lendres/PCB-Name-Plate-Class-Project/Name Plate Class Project.kicad_pcb

## KiCad design Name Plate Class Project.kicad_pcb (2020-07-08)

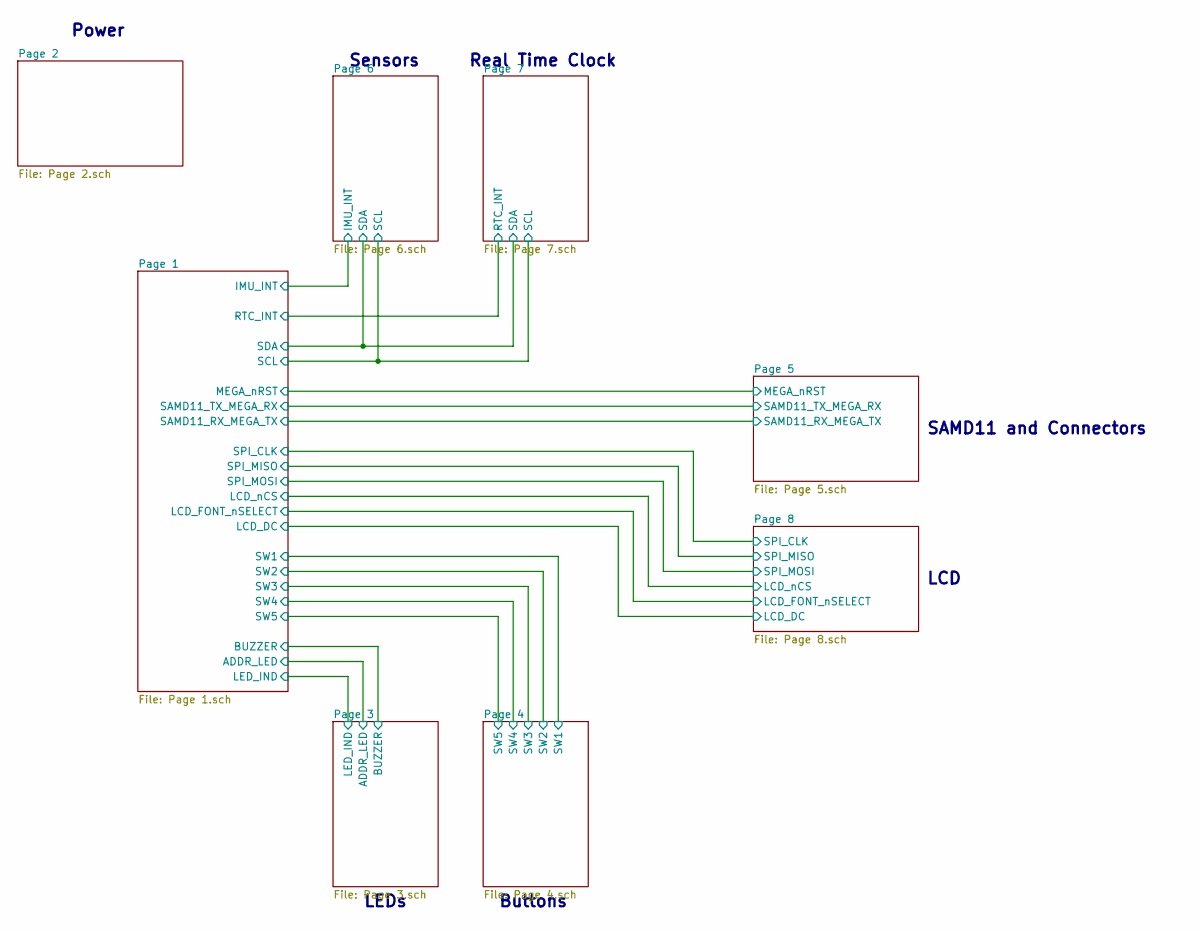
[picture p1: schematic Name Plate Class Project.sch]

Notes on the sheet:
LCD
SAMD11 and Connectors
Real Time Clock
Sensors
Power
LEDs
Buttons

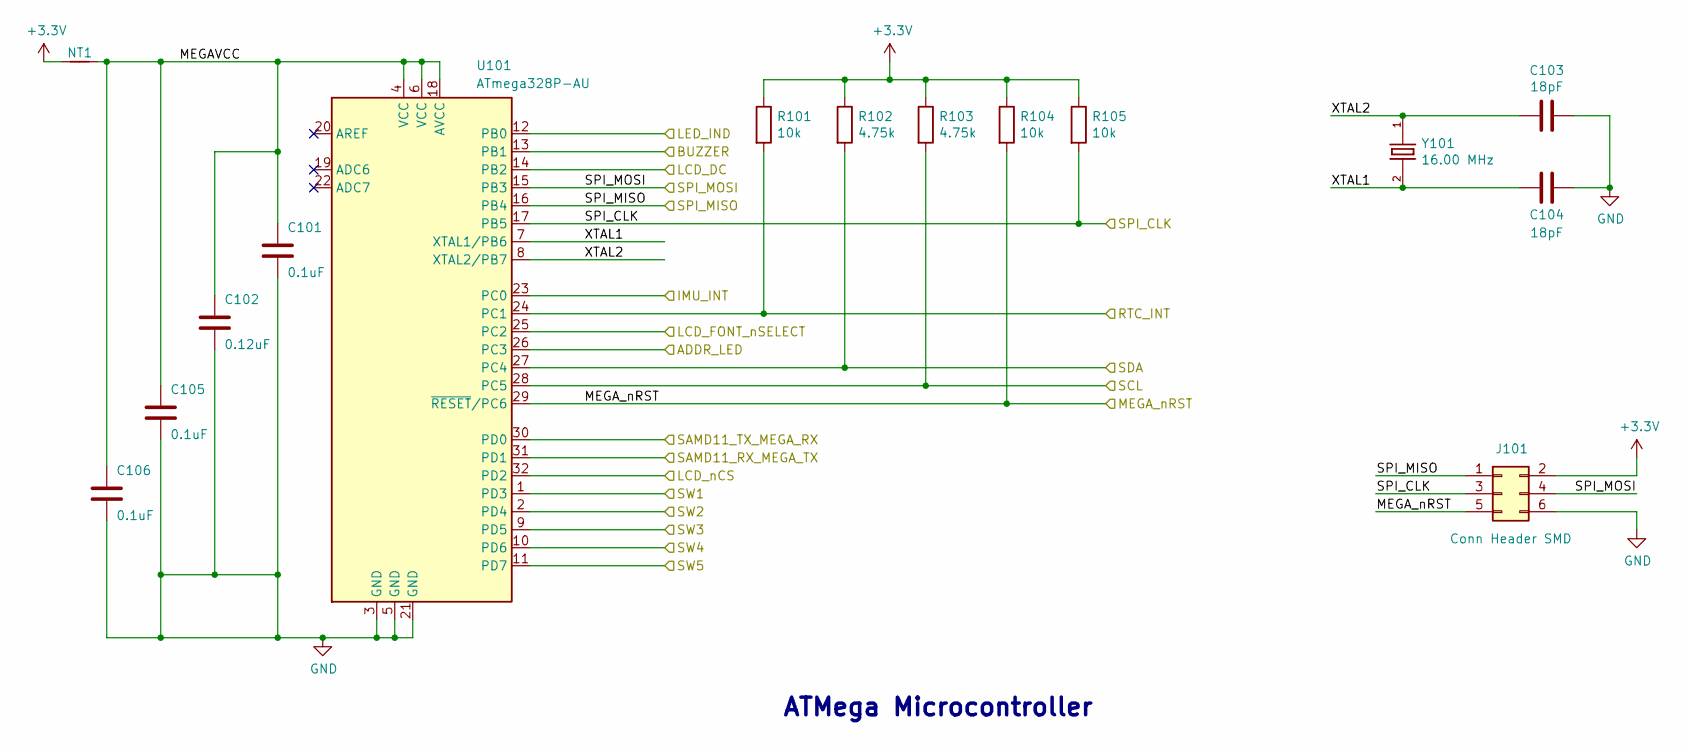
[picture p2: schematic Page 1.sch]

Parts:
C101, C105, C106: 0.1uF; C_0603_1608Metric_Pad1.05x0.95mm_HandSolder; Mftr Part No. CC0603KPX7R7BB104; DigiKey Part No. 311-1335-1-ND
C102: 0.12uF; C_0805_2012Metric_Pad1.15x1.40mm_HandSolder; Mftr Part No. 08053C124KAT2A; DigiKey Part No. 478-5161-1-ND
C103, C104: 18pF; C_0603_1608Metric_Pad1.05x0.95mm_HandSolder; Mftr Part No. C0603C180J5GACTU; DigiKey Part No. 399-1052-1-ND
J101: Conn Header SMD; Molex_PinHeader_2x03; Mftr Part No. 713085406; DigiKey Part No. 0713085406-ND
NT1: Net-Tie_2; NetTie-2_SMD_Pad0.5mm; Mftr Part No. None; DigiKey Part No. None
R101, R104, R105: 10k; R_0603_1608Metric_Pad1.05x0.95mm_HandSolder; Mftr Part No. RC0603JR-0710KL; DigiKey Part No. 311-10KGRCT-ND
R102, R103: 4.75k; R_0603_1608Metric_Pad1.05x0.95mm_HandSolder; Mftr Part No. RC0603JR-074K7L; DigiKey Part No. 311-10KGRCT-ND
U101: ATmega328P-AU; TQFP-32_7x7mm_P0.8mm; Mftr Part No. ATMega328P-AU; DigiKey Part No. ATMEGA328P-AURCT-ND
Y101: 16.00 MHz; Oscillator_ABM3-16.000MHZ-B2-T; Mftr Part No. ABM3-16.000MHZ-B2-T; DigiKey Part No. 535-9103-1-ND

Connections:
+3V3: J101.2, NT1.1, R101.1, R102.1, R103.1, R104.1, R105.1; also elsewhere on the board
/Page 1/ADDR_LED: U101.26 (PC3); also elsewhere on the board
/Page 1/BUZZER: U101.13 (PB1); also elsewhere on the board
/Page 1/IMU_INT: U101.23 (PC0); also elsewhere on the board
/Page 1/LCD_DC: U101.14 (PB2); also elsewhere on the board
/Page 1/LCD_FONT_nSELECT: U101.25 (PC2); also elsewhere on the board
/Page 1/LCD_nCS: U101.32 (PD2); also elsewhere on the board
/Page 1/LED_IND: U101.12 (PB0); also elsewhere on the board
/Page 1/MEGAVCC: C101.1, C102.1, C105.1, C106.1, NT1.2, U101.4 (VCC), U101.6 (VCC), U101.18 (AVCC)
/Page 1/MEGA_nRST: J101.5, R104.2, U101.29 (~RESET~/PC6); also elsewhere on the board
/Page 1/RTC_INT: R101.2, U101.24 (PC1); also elsewhere on the board
/Page 1/SAMD11_RX_MEGA_TX: U101.31 (PD1); also elsewhere on the board
/Page 1/SAMD11_TX_MEGA_RX: U101.30 (PD0); also elsewhere on the board
/Page 1/SCL: R103.2, U101.28 (PC5); also elsewhere on the board
/Page 1/SDA: R102.2, U101.27 (PC4); also elsewhere on the board
/Page 1/SPI_CLK: J101.3, R105.2, U101.17 (PB5); also elsewhere on the board
/Page 1/SPI_MISO: J101.1, U101.16 (PB4); also elsewhere on the board
/Page 1/SPI_MOSI: J101.4, U101.15 (PB3); also elsewhere on the board
/Page 1/SW1: U101.1 (PD3); also elsewhere on the board
/Page 1/SW2: U101.2 (PD4); also elsewhere on the board
/Page 1/SW3: U101.9 (PD5); also elsewhere on the board
/Page 1/SW4: U101.10 (PD6); also elsewhere on the board
/Page 1/SW5: U101.11 (PD7); also elsewhere on the board
/Page 1/XTAL1: C104.2, U101.7 (XTAL1/PB6), Y101.2
/Page 1/XTAL2: C103.2, U101.8 (XTAL2/PB7), Y101.1
GND: C101.2, C102.2, C103.1, C104.1, C105.2, C106.2, J101.6, U101.3 (GND), U101.5 (GND), U101.21 (GND); also elsewhere on the board

Notes on the sheet:
ATMega Microcontroller

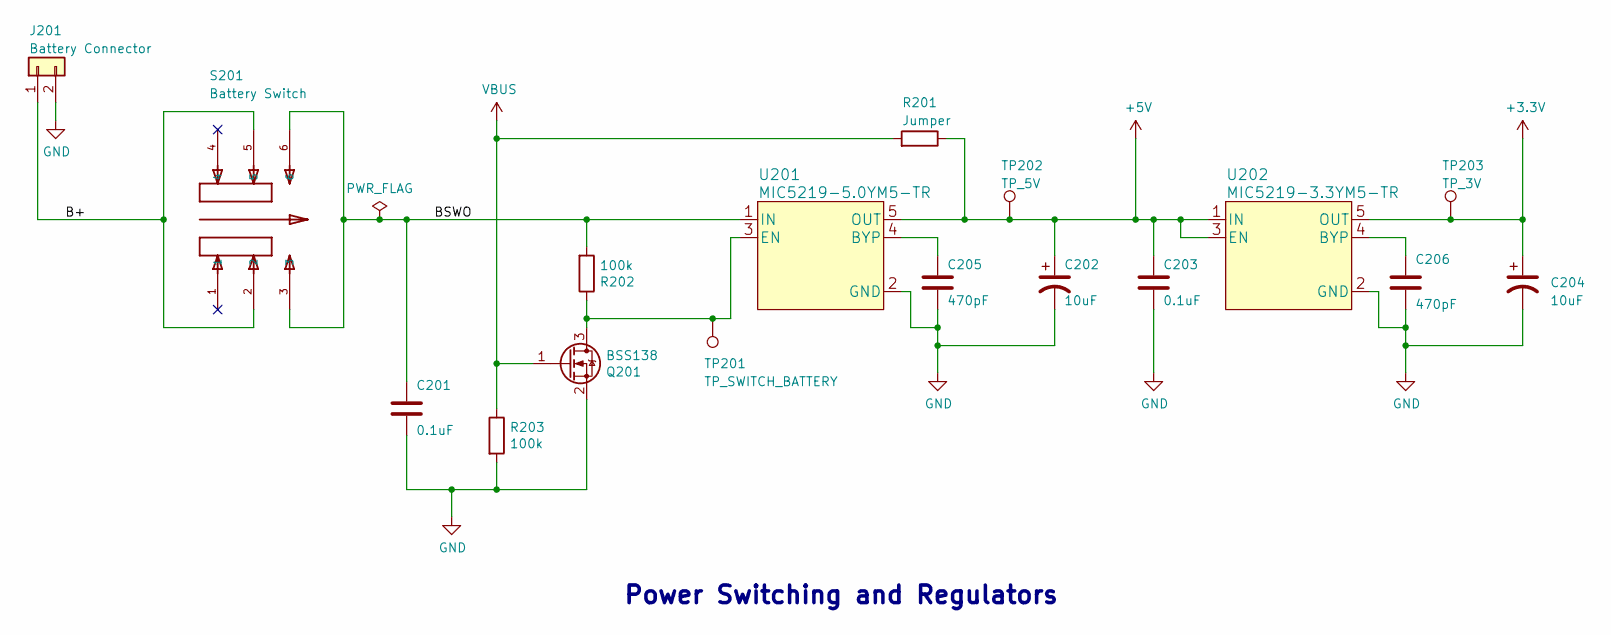
[picture p3: schematic Page 2.sch]

Parts:
C201, C203: 0.1uF; C_0603_1608Metric_Pad1.05x0.95mm_HandSolder; Mftr Part No. CC0603KPX7R7BB104; DigiKey Part No. 311-1335-1-ND
C202, C204: 10uF; T491A106K010AT; Mftr Part No. T491A106K010AT; DigiKey Part No. 399-3684-1-ND
C205, C206: 470pF; C_0603_1608Metric_Pad1.05x0.95mm_HandSolder; Mftr Part No. CC0603MRX7R9BB471; DigiKey Part No. 311-3377-1-ND
J201: Battery Connector; JST_PH_w_SolderPoints; Mftr Part No. S2B-PH-SM4-TB(LF)(SN); DigiKey Part No. 455-1749-1-ND
Q201: BSS138; SOT-23; Mftr Part No. BSS138; DigiKey Part No. BSS138CT-ND
R201: Jumper; R_0603_1608Metric_Pad1.05x0.95mm_HandSolder; Mftr Part No. 311-10KGRCT-ND; DigiKey Part No. RC0603JR-070RL
R202, R203: 100k; R_0603_1608Metric_Pad1.05x0.95mm_HandSolder; Mftr Part No. RC0603JR-07100KL; DigiKey Part No. 311-100KGRCT-ND
S201: Battery Switch; Switch_JS202011SCQN; Mftr Part No. JS202011SCQN; DigiKey Part No. 401-2002-1-ND
TP201, TP202, TP203: Test Point; Pad_2.5-2.5; Mftr Part No. None; DigiKey Part No. None
U201: MIC5219-5.0YM5-TR; SOT-23-5_HandSoldering; Mftr Part No. MIC5219-5.0YM5-TR; DigiKey Part No. 576-2770-6-ND
U202: MIC5219-3.3YM5-TR; SOT-23-5_HandSoldering; Mftr Part No. MIC5219-3.3YM5-TR; DigiKey Part No. 576-1281-6-ND

Connections:
+3V3: C204.1 (+), TP203.1, U202.5 (OUT); also elsewhere on the board
+5V: C202.1 (+), C203.1, R201.1, TP202.1, U201.5 (OUT), U202.1 (IN), U202.3 (EN); also elsewhere on the board
/Page 2/B+: J201.1, S201.2, S201.5
/Page 2/BSWO: C201.1, R202.2, S201.3, S201.6, U201.1 (IN)
GND: C201.2, C202.2 (-), C203.2, C204.2 (-), C205.2, C206.2, J201.2, Q201.2 (S), R203.2, U201.2 (GND), U202.2 (GND); also elsewhere on the board
unnamed: C205.1, U201.4 (BYP)
unnamed: C206.1, U202.4 (BYP)
unnamed: Q201.3 (D), R202.1, TP201.1, U201.3 (EN)
VBUS: Q201.1 (G), R201.2, R203.1; also elsewhere on the board

Notes on the sheet:
Power Switching and Regulators

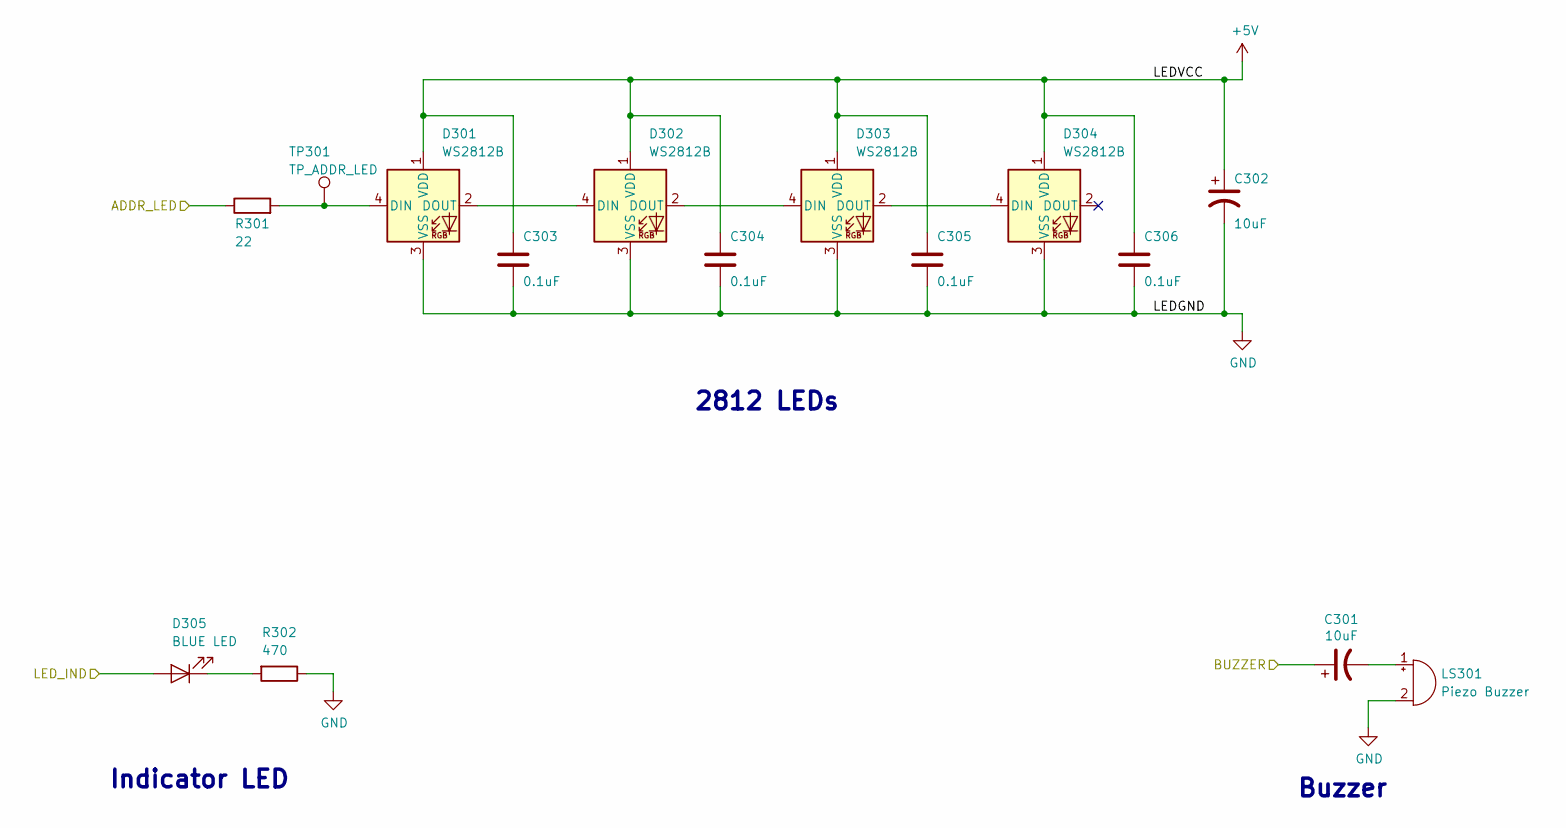
[picture p4: schematic Page 3.sch]

Parts:
C301, C302: 10uF; T491A106K010AT; Mftr Part No. T491A106K010AT; DigiKey Part No. 399-3684-1-ND
C303, C304, C305, C306: 0.1uF; C_0603_1608Metric_Pad1.05x0.95mm_HandSolder; Mftr Part No. CC0603KPX7R7BB104; DigiKey Part No. 311-1335-1-ND
D301, D302, D303, D304: WS2812B; LED_WS2812B_PLCC4_5.0x5.0mm_P3.2mm; Mftr Part No. 3094; DigiKey Part No. 1528-2388-ND
D305: BLUE LED; LED_G-GX; Mftr Part No. LB Q39G-L2OO-35-1; DigiKey Part No. 475-2816-1-ND
LS301: Piezo Buzzer; Buzzer_TDK_PS1240P02BT_D12.2mm_H6.5mm; Mftr Part No. AB1541B-LW100-R; DigiKey Part No. 668-1448-ND
R301: 22; R_0603_1608Metric_Pad1.05x0.95mm_HandSolder; Mftr Part No. CRGCQ0603J22R; DigiKey Part No. A130081CT-ND
R302: 470; R_0603_1608Metric_Pad1.05x0.95mm_HandSolder; Mftr Part No. CRGCQ0603J470R; DigiKey Part No. A130089CT-ND
TP301: Test Point; Pad_2.5-2.5; Mftr Part No. None; DigiKey Part No. None

Connections:
+5V: C302.1 (+), C303.1, C304.1, C305.1, C306.1, D301.1 (VDD), D302.1 (VDD), D303.1 (VDD), D304.1 (VDD); also elsewhere on the board
/Page 1/ADDR_LED: R301.1; also elsewhere on the board
/Page 1/BUZZER: C301.1 (+); also elsewhere on the board
/Page 1/LED_IND: D305.2 (A); also elsewhere on the board
GND: C302.2 (-), C303.2, C304.2, C305.2, C306.2, D301.3 (VSS), D302.3 (VSS), D303.3 (VSS), D304.3 (VSS), LS301.2 (+), R302.1; also elsewhere on the board
unnamed: C301.2 (-), LS301.1 (-)
unnamed: D301.2 (DOUT), D302.4 (DIN)
unnamed: D301.4 (DIN), R301.2, TP301.1
unnamed: D302.2 (DOUT), D303.4 (DIN)
unnamed: D303.2 (DOUT), D304.4 (DIN)
unnamed: D305.1 (K), R302.2

Notes on the sheet:
2812 LEDs
Indicator LED
Buzzer

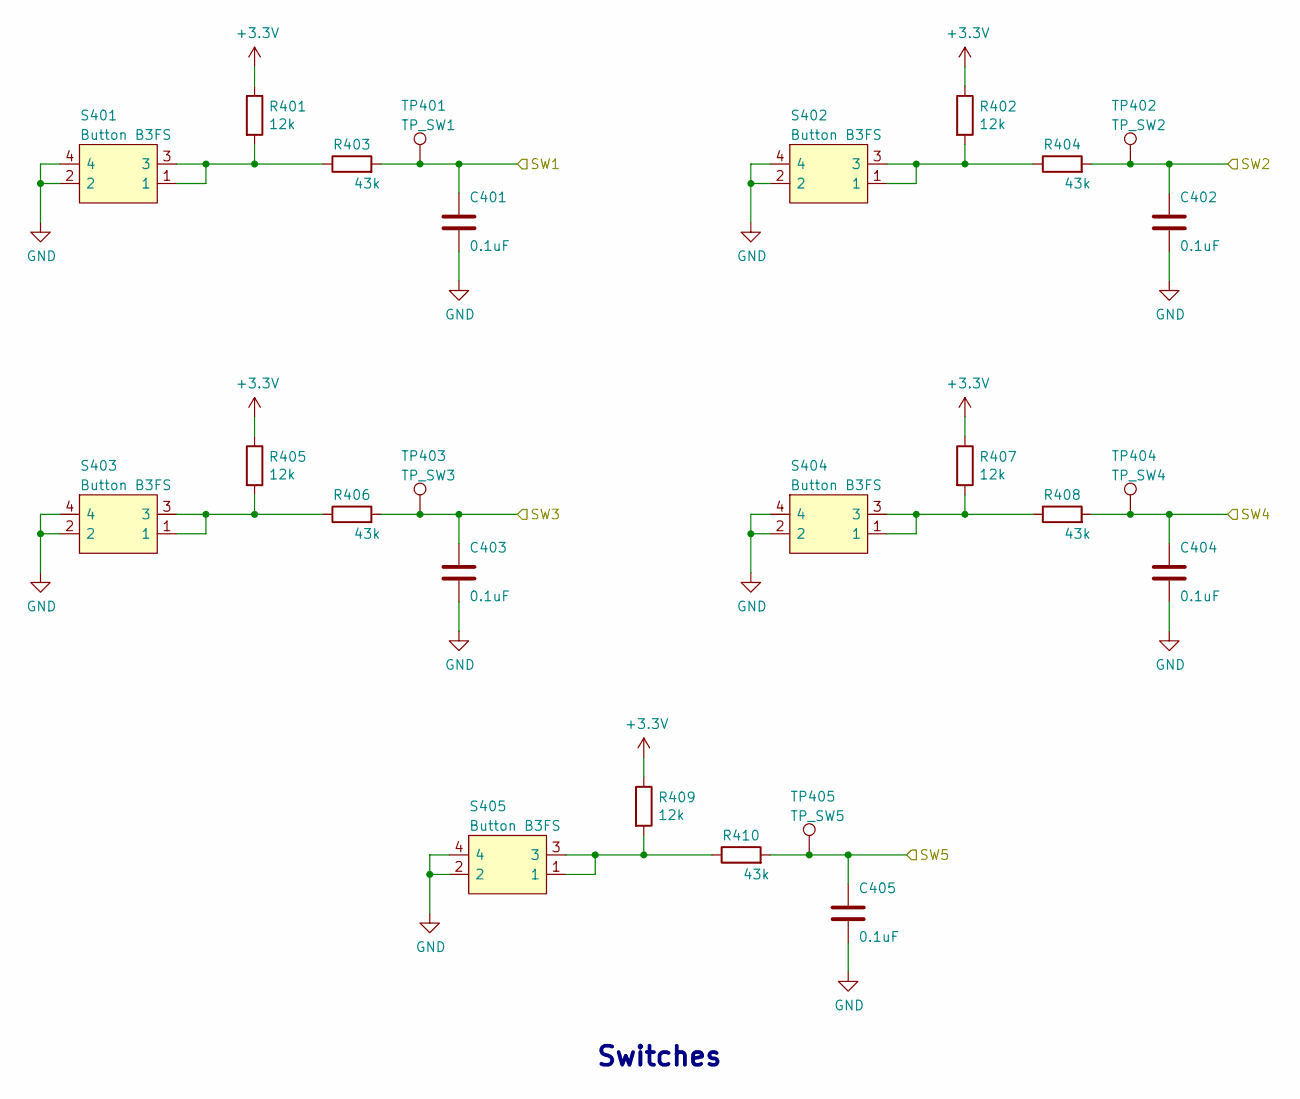
[picture p5: schematic Page 4.sch]

Parts:
C401, C402, C403, C404, C405: 0.1uF; C_0603_1608Metric_Pad1.05x0.95mm_HandSolder; Mftr Part No. CC0603KPX7R7BB104; DigiKey Part No. 311-1335-1-ND
R401, R402, R405, R407, R409: 12k; R_0603_1608Metric_Pad1.05x0.95mm_HandSolder; Mftr Part No. RC0603JR-0712KL; DigiKey Part No. 311-12KGRCT-ND
R403, R404, R406, R408, R410: 43k; R_0603_1608Metric_Pad1.05x0.95mm_HandSolder; Mftr Part No. RC0603JR-0743KL; DigiKey Part No. 311-43KGRCT-ND
S401, S402, S403, S404, S405: Button B3FS; Button_B3FS-1000P; Mftr Part No. B3FS-1000P; DigiKey Part No. SW423DKR-ND
TP401, TP402, TP403, TP404, TP405: Test Point; Pad_2.5-2.5; Mftr Part No. None; DigiKey Part No. None

Connections:
+3V3: R401.1, R402.1, R405.1, R407.1, R409.1; also elsewhere on the board
/Page 1/SW1: C401.1, R403.2, TP401.1; also elsewhere on the board
/Page 1/SW2: C402.1, R404.2, TP402.1; also elsewhere on the board
/Page 1/SW3: C403.1, R406.2, TP403.1; also elsewhere on the board
/Page 1/SW4: C404.1, R408.2, TP404.1; also elsewhere on the board
/Page 1/SW5: C405.1, R410.2, TP405.1; also elsewhere on the board
GND: C401.2, C402.2, C403.2, C404.2, C405.2, S401.2, S401.4, S402.2, S402.4, S403.2, S403.4, S404.2, S404.4, S405.2, S405.4; also elsewhere on the board
unnamed: R401.2, R403.1, S401.1, S401.3
unnamed: R402.2, R404.1, S402.1, S402.3
unnamed: R405.2, R406.1, S403.1, S403.3
unnamed: R407.2, R408.1, S404.1, S404.3
unnamed: R409.2, R410.1, S405.1, S405.3

Notes on the sheet:
Switches

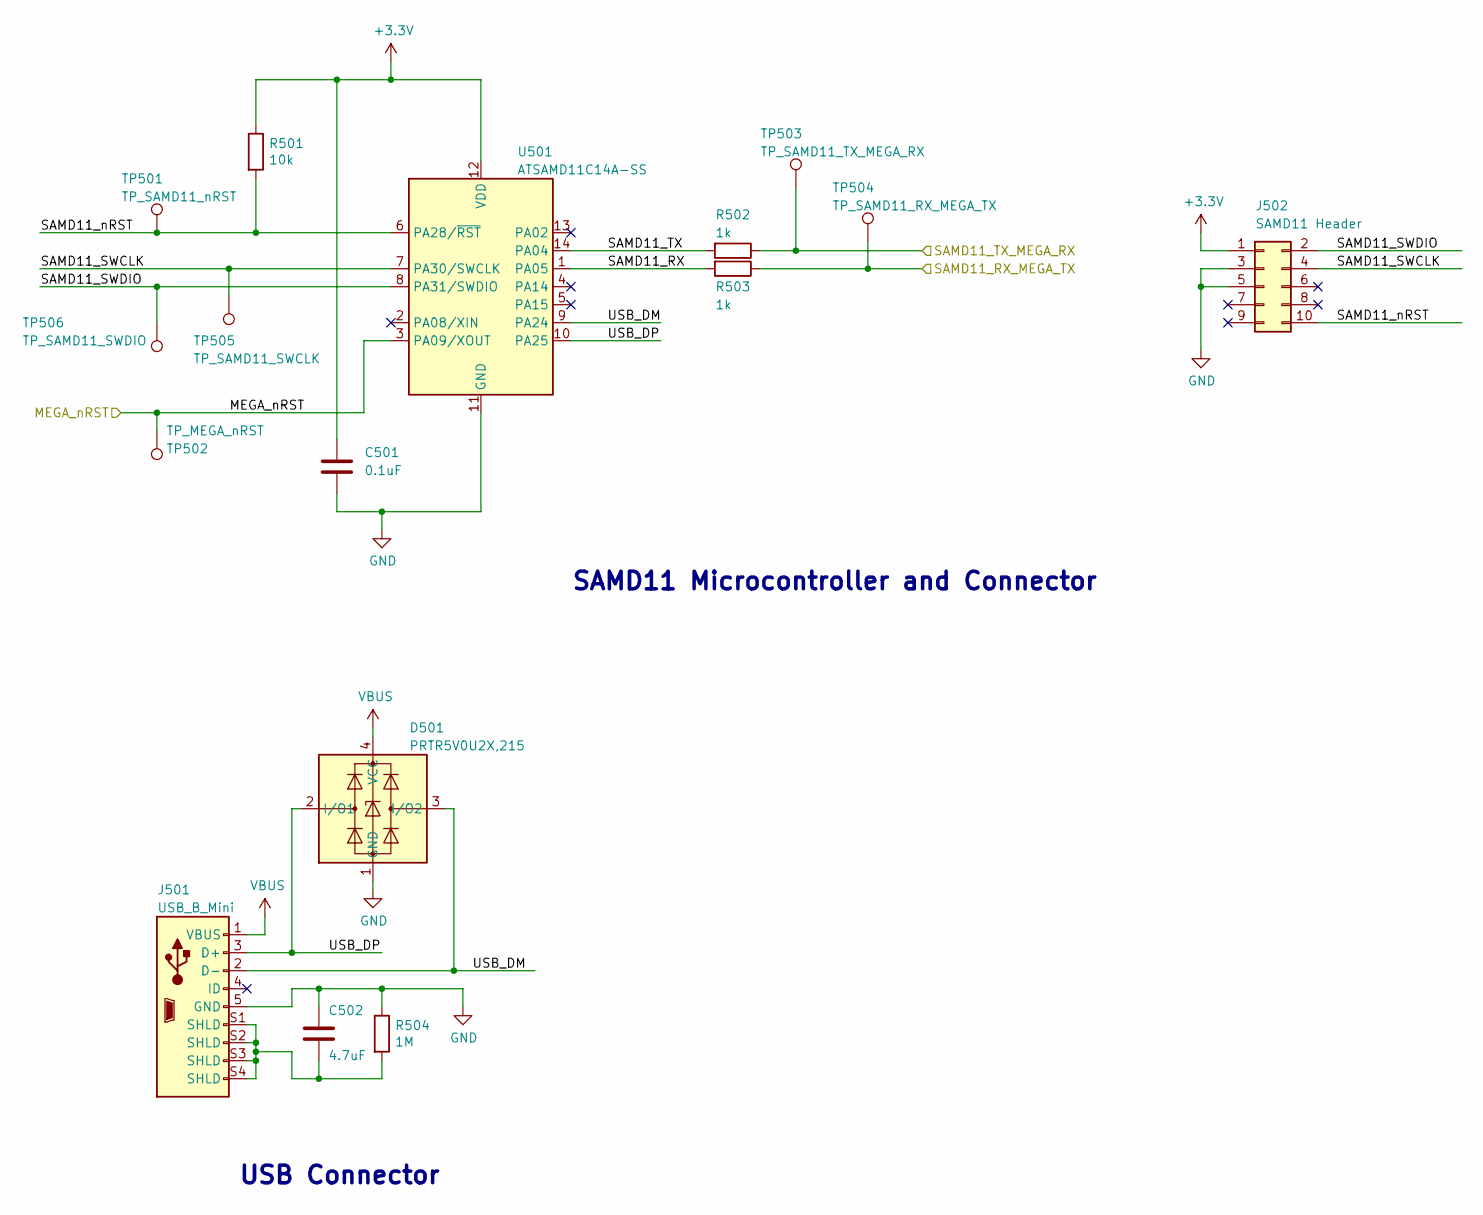
[picture p6: schematic Page 5.sch]

Parts:
C501: 0.1uF; C_0603_1608Metric_Pad1.05x0.95mm_HandSolder; Mftr Part No. CC0603KPX7R7BB104; DigiKey Part No. 311-1335-1-ND
C502: 4.7uF; C_0603_1608Metric_Pad1.05x0.95mm_HandSolder; Mftr Part No. C0805C472KDRACTU; DigiKey Part No. 399-6738-1-ND
D501: PRTR5V0U2X,215; SOT-143-4; Mftr Part No. PRTR5V0U2X,215; DigiKey Part No. 1727-3884-6-ND
J501: USB_B_Mini; Molex_USB_Mini_B_548190572; Mftr Part No. 548190572; DigiKey Part No. WM17116DKR-ND
J502: SAMD11 Header; SAMTEC-FTS-105-01-X-DV; Mftr Part No. FTS-105-01-L-DV; DigiKey Part No. SAM1157-05-ND
R501: 10k; R_0603_1608Metric_Pad1.05x0.95mm_HandSolder; Mftr Part No. RC0603JR-0710KL; DigiKey Part No. 311-10KGRCT-ND
R502, R503: 1k; R_0603_1608Metric_Pad1.05x0.95mm_HandSolder; Mftr Part No. RC0603JR-071KL; DigiKey Part No. 311-1.0KGRCT-ND
R504: 1M; R_0603_1608Metric_Pad1.05x0.95mm_HandSolder; Mftr Part No. RC0603FR-071ML; DigiKey Part No. 311-1.00MHRCT-ND
TP501, TP502, TP503, TP504, TP505, TP506: Test Point; Pad_2.5-2.5; Mftr Part No. None; DigiKey Part No. None
U501: ATSAMD11C14A-SS; SOIC-14_3.9x8.7mm_P1.27mm; Mftr Part No. ATSAMD11C14A-SSNT; DigiKey Part No. ATSAMD11C14A-SSNTDKR-ND

Connections:
+3V3: C501.1, J502.1, R501.1, U501.12 (VDD); also elsewhere on the board
/Page 1/MEGA_nRST: TP502.1, U501.3 (PA09/XOUT); also elsewhere on the board
/Page 1/SAMD11_RX_MEGA_TX: R503.1, TP504.1; also elsewhere on the board
/Page 1/SAMD11_TX_MEGA_RX: R502.1, TP503.1; also elsewhere on the board
/Page 5/SAMD11_RX: R503.2, U501.1 (PA05)
/Page 5/SAMD11_SWCLK: J502.4, TP505.1, U501.7 (PA30/SWCLK)
/Page 5/SAMD11_SWDIO: J502.2, TP506.1, U501.8 (PA31/SWDIO)
/Page 5/SAMD11_TX: R502.2, U501.14 (PA04)
/Page 5/SAMD11_nRST: J502.10, R501.2, TP501.1, U501.6 (PA28/~RST)
/Page 5/USB_DM: D501.3 (I/O2), J501.2 (D-), U501.9 (PA24)
/Page 5/USB_DP: D501.2 (I/O1), J501.3 (D+), U501.10 (PA25)
GND: C501.2, C502.1, D501.1 (GND), J501.5 (GND), J502.3, J502.5, R504.1, U501.11 (GND); also elsewhere on the board
unnamed: C502.2, J501.S1 (SHLD), J501.S2 (SHLD), J501.S3 (SHLD), J501.S4 (SHLD), R504.2
VBUS: D501.4 (VCC), J501.1 (VBUS); also elsewhere on the board

Notes on the sheet:
SAMD11 Microcontroller and Connector
USB Connector

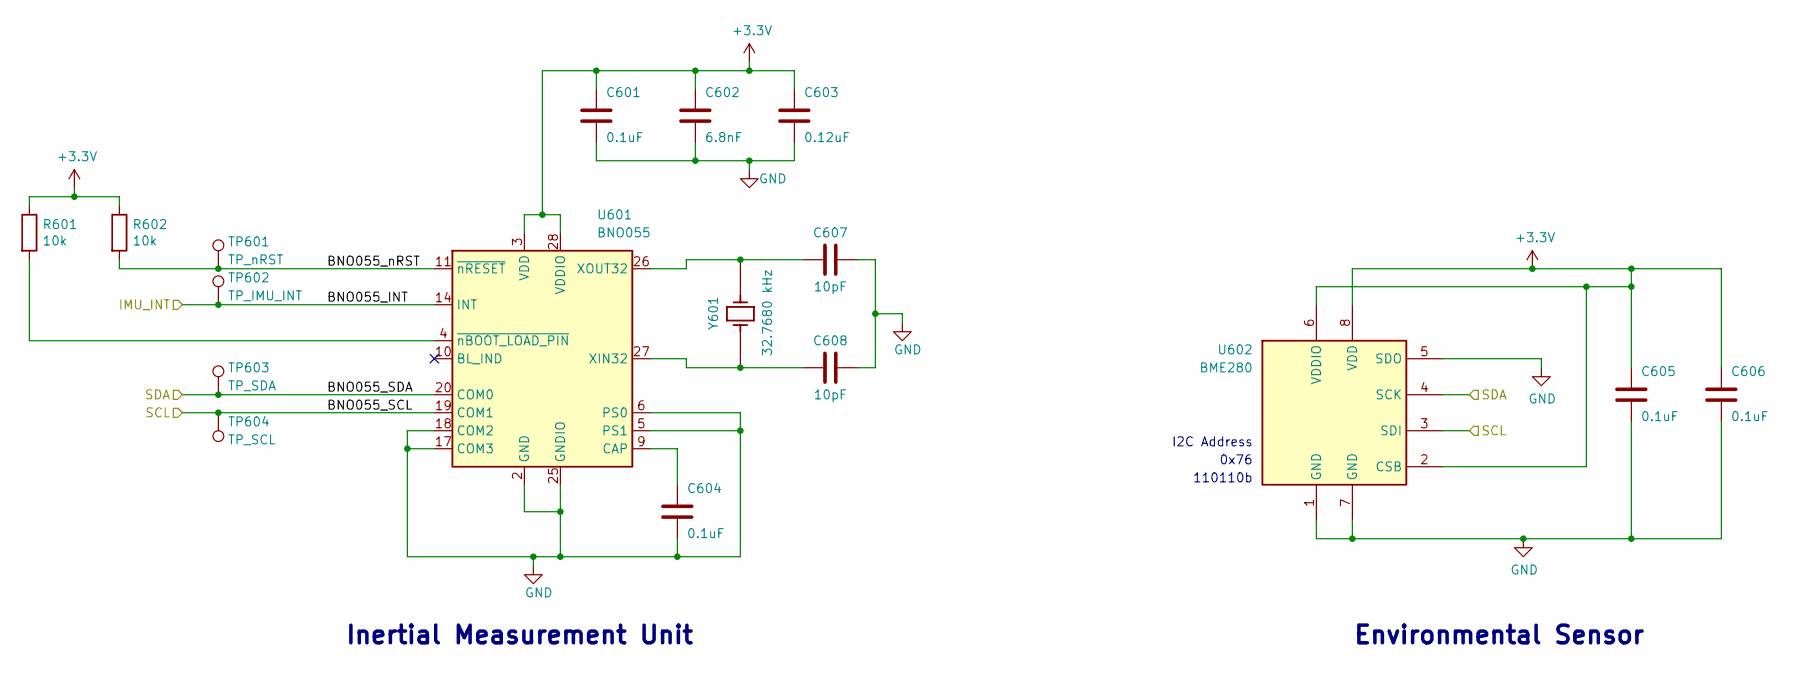
[picture p7: schematic Page 6.sch]

Parts:
C601, C604, C605, C606: 0.1uF; C_0603_1608Metric_Pad1.05x0.95mm_HandSolder; Mftr Part No. CC0603KPX7R7BB104; DigiKey Part No. 311-1335-1-ND
C602: 6.8nF; C_0603_1608Metric_Pad1.05x0.95mm_HandSolder; Mftr Part No. CAPC160X80X92L35; DigiKey Part No. 732-7932-1-ND
C603: 0.12uF; C_0805_2012Metric_HandSolder; Mftr Part No. 08053C124KAT2A; DigiKey Part No. 478-5161-1-ND
C607, C608: 10pF; C_0603_1608Metric_Pad1.05x0.95mm_HandSolder; Mftr Part No. C0603C100J1GACTU; DigiKey Part No. 399-7816-1-ND
R601, R602: 10k; R_0603_1608Metric_Pad1.05x0.95mm_HandSolder; Mftr Part No. RC0603JR-0710KL; DigiKey Part No. 311-10KGRCT-ND
TP601, TP602, TP603, TP604: Test Point; Pad_2.5-2.5; Mftr Part No. None; DigiKey Part No. None
U601: BNO055; LGA-28_5.2x3.8mm_P0.5mm; Mftr Part No. BOSCH_BNO055; DigiKey Part No. 828-1058-1-ND
U602: BME280; Bosch_LGA-8_2.5x2.5mm_P0.65mm_ClockwisePinNumbering; Mftr Part No. BOSCH_BME280; DigiKey Part No. 828-1063-1-ND
Y601: 32.7680 kHz; Oscillator_MC-405_32.7680K-D__ROHS; Mftr Part No. MC-405 32.7680K-E3: ROHS; DigiKey Part No. SER4311TR-ND

Connections:
+3V3: C601.1, C602.1, C603.1, C605.1, C606.1, R601.1, R602.1, U601.3 (VDD), U601.28 (VDDIO), U602.2 (CSB), U602.6 (VDDIO), U602.8 (VDD); also elsewhere on the board
/Page 1/IMU_INT: TP602.1, U601.14 (INT); also elsewhere on the board
/Page 1/SCL: TP604.1, U601.19 (COM1), U602.3 (SDI); also elsewhere on the board
/Page 1/SDA: TP603.1, U601.20 (COM0), U602.4 (SCK); also elsewhere on the board
/Page 6/BNO055_nRST: R602.2, TP601.1, U601.11 (~nRESET)
GND: C601.2, C602.2, C603.2, C604.2, C605.2, C606.2, C607.1, C608.1, U601.2 (GND), U601.5 (PS1), U601.6 (PS0), U601.15 (GNDIO), U601.16 (GNDIO), U601.17 (COM3), U601.18 (COM2), U601.25 (GNDIO), U602.1 (GND), U602.5 (SDO), U602.7 (GND); also elsewhere on the board
unnamed: C604.1, U601.9 (CAP)
unnamed: C607.2, U601.26 (XOUT32), Y601.1
unnamed: C608.2, U601.27 (XIN32), Y601.2
unnamed: R601.2, U601.4 (~nBOOT_LOAD_PIN)

Notes on the sheet:
I2C Address
0x76
110110b
Environmental Sensor
Inertial Measurement Unit

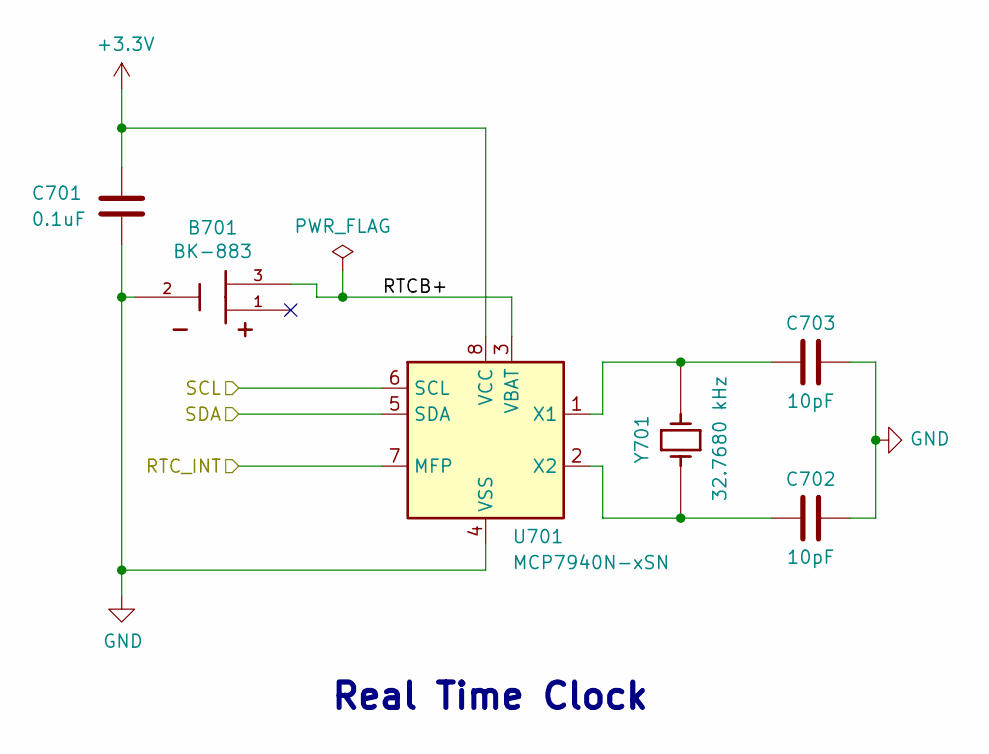
[picture p8: schematic Page 7.sch]

Parts:
B701: BK-883; BAT_BK-883; Mftr Part No. BK-883; DigiKey Part No. BK-883-ND
C701: 0.1uF; C_0603_1608Metric_Pad1.05x0.95mm_HandSolder; Mftr Part No. CC0603KPX7R7BB104; DigiKey Part No. 311-1335-1-ND
C702, C703: 10pF; C_0603_1608Metric_Pad1.05x0.95mm_HandSolder; Mftr Part No. C0603C100J1GACTU; DigiKey Part No. 399-7816-1-ND
U701: MCP7940N-xSN; SOIC-8_3.9x4.9mm_P1.27mm; Mftr Part No. MCP79400-I/SN; DigiKey Part No. MCP79400-I/SN-ND
Y701: 32.7680 kHz; Oscillator_MC-405_32.7680K-D__ROHS; Mftr Part No. MC-405 32.7680K-E3: ROHS; DigiKey Part No. SER4311TR-ND

Connections:
+3V3: C701.1, U701.8 (VCC); also elsewhere on the board
/Page 1/RTC_INT: U701.7 (MFP); also elsewhere on the board
/Page 1/SCL: U701.6 (SCL); also elsewhere on the board
/Page 1/SDA: U701.5 (SDA); also elsewhere on the board
/Page 7/RTCB+: B701.3 (VCC), U701.3 (VBAT)
GND: B701.2 (GND), C701.2, C702.1, C703.1, U701.4 (VSS); also elsewhere on the board
unnamed: C702.2, U701.2 (X2), Y701.2
unnamed: C703.2, U701.1 (X1), Y701.1

Notes on the sheet:
Real Time Clock

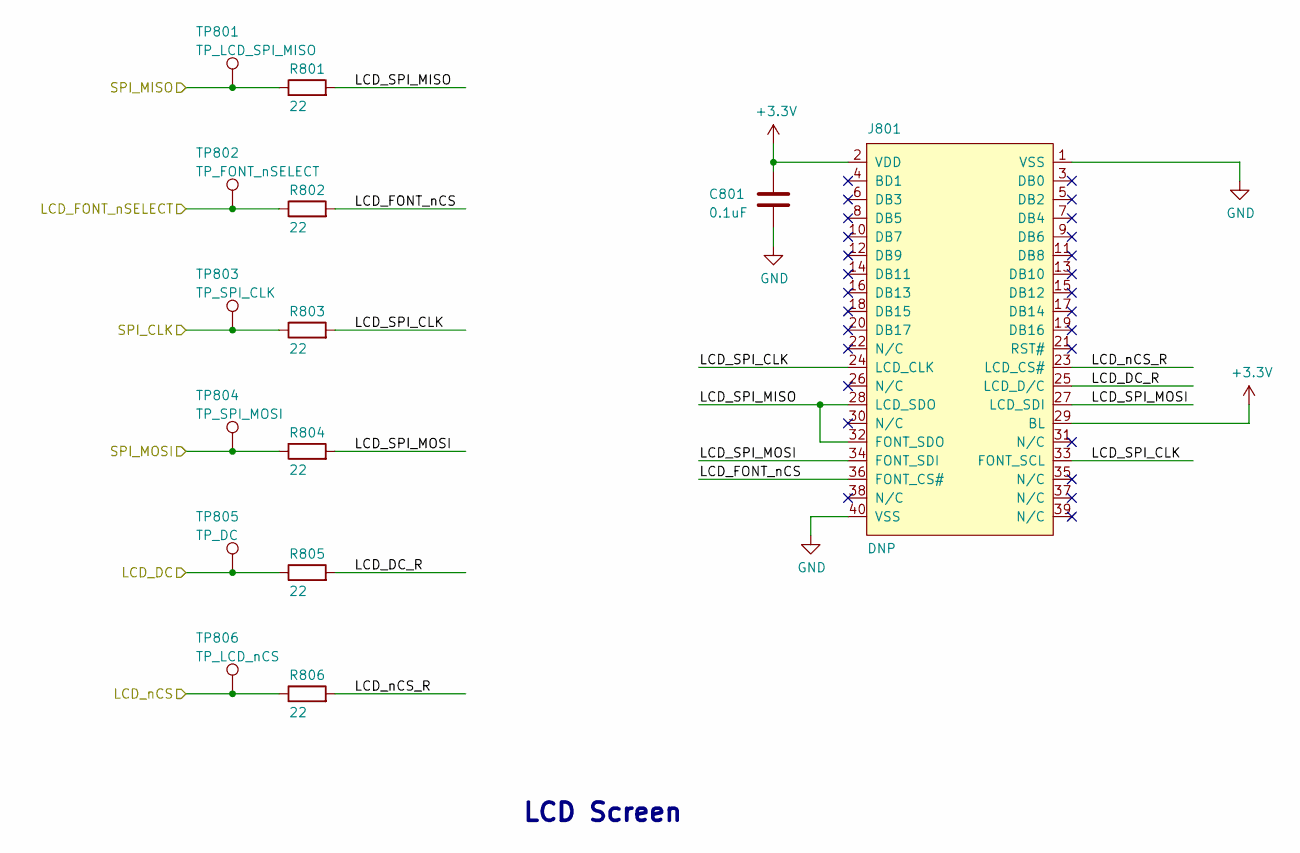
[picture p9: schematic Page 8.sch]

Parts:
C801: 0.1uF; C_0603_1608Metric_Pad1.05x0.95mm_HandSolder; Mftr Part No. CC0603KPX7R7BB104; DigiKey Part No. 311-1335-1-ND
J801: DNP; LCD_ER-TFTM024-3_SMD; Mftr Part No. NPTC202KFMS-RC; DigiKey Part No. S5690-ND
R801, R802, R803, R804, R805, R806: 22; R_0603_1608Metric_Pad1.05x0.95mm_HandSolder; Mftr Part No. CRGCQ0603J22R; DigiKey Part No. A130081CT-ND
TP801, TP802, TP803, TP804, TP805, TP806: Test Point; Pad_2.5-2.5; Mftr Part No. None; DigiKey Part No. None

Connections:
+3V3: C801.1, J801.2 (VDD), J801.29 (BL); also elsewhere on the board
/Page 1/LCD_DC: R805.1, TP805.1; also elsewhere on the board
/Page 1/LCD_FONT_nSELECT: R802.1, TP802.1; also elsewhere on the board
/Page 1/LCD_nCS: R806.1, TP806.1; also elsewhere on the board
/Page 1/SPI_CLK: R803.1, TP803.1; also elsewhere on the board
/Page 1/SPI_MISO: R801.1, TP801.1; also elsewhere on the board
/Page 1/SPI_MOSI: R804.1, TP804.1; also elsewhere on the board
/Page 8/LCD_DC_R: J801.25 (LCD_D/C), R805.2
/Page 8/LCD_FONT_nCS: J801.36 (FONT_CS#), R802.2
/Page 8/LCD_SPI_CLK: J801.24 (LCD_CLK), J801.33 (FONT_SCL), R803.2
/Page 8/LCD_SPI_MISO: J801.28 (LCD_SDO), J801.32 (FONT_SDO), R801.2
/Page 8/LCD_SPI_MOSI: J801.27 (LCD_SDI), J801.34 (FONT_SDI), R804.2
/Page 8/LCD_nCS_R: J801.23 (LCD_CS#), R806.2
GND: C801.2, J801.1 (VSS), J801.40 (VSS); also elsewhere on the board

Notes on the sheet:
LCD Screen

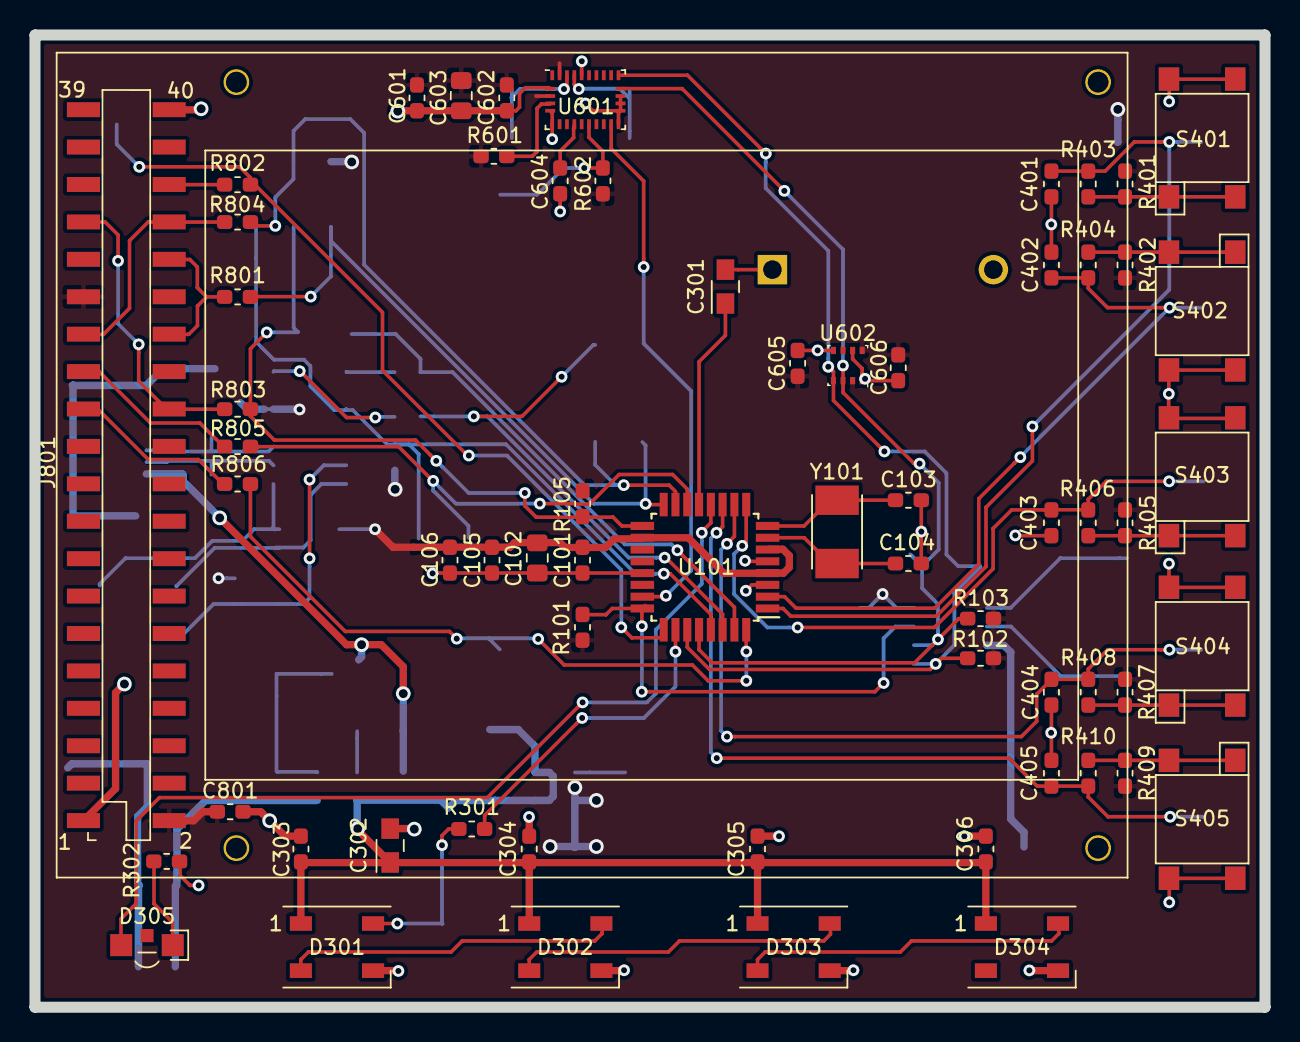
[picture p10: board Name Plate Class Project.kicad_pcb from above]

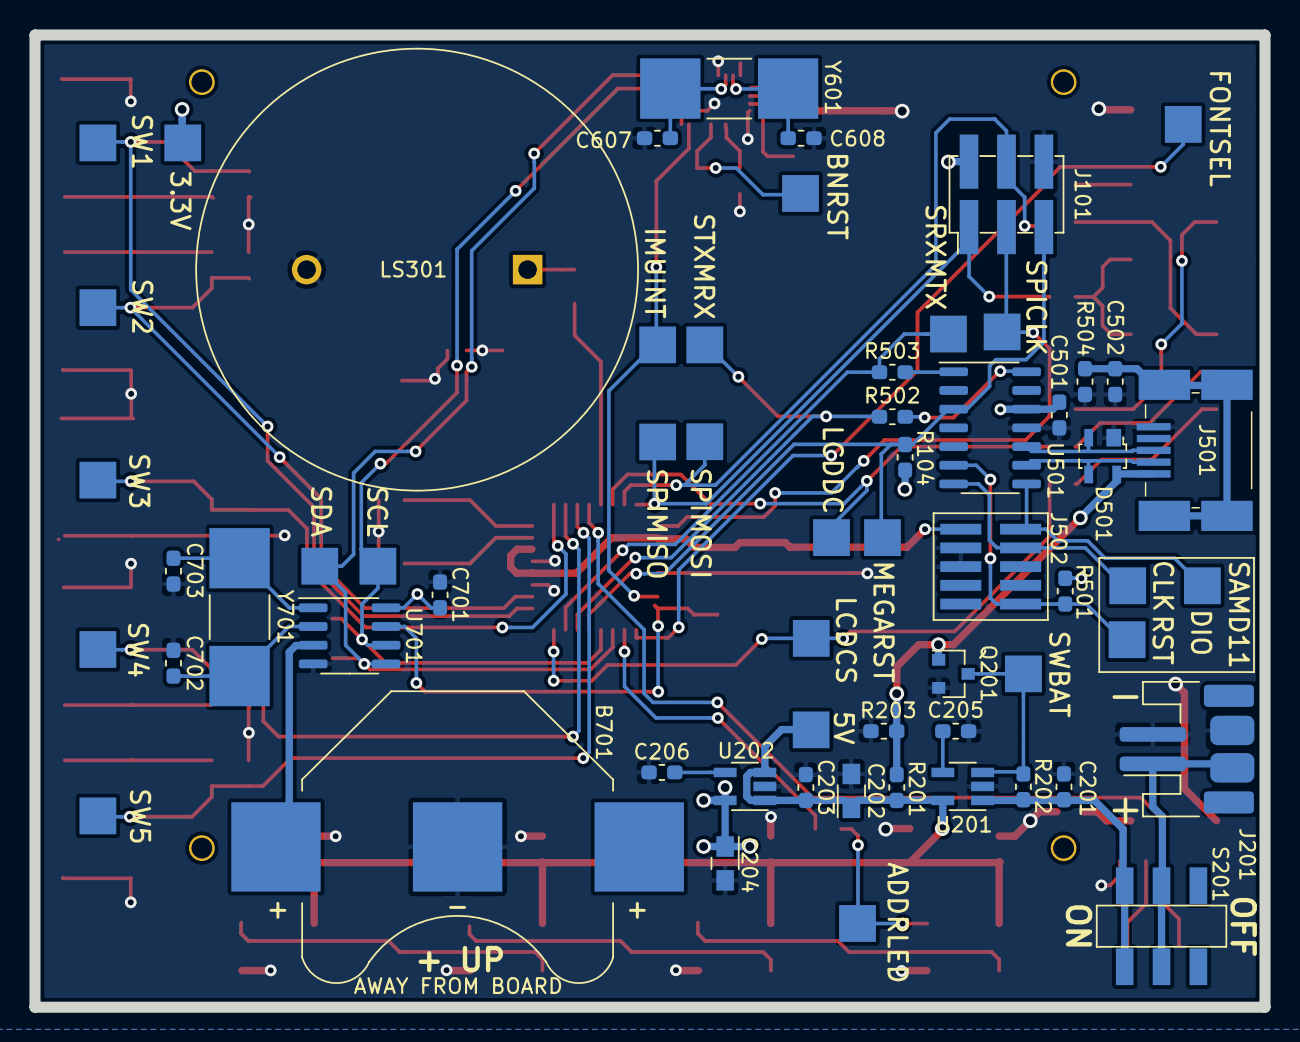
[picture p11: board Name Plate Class Project.kicad_pcb from below]

Board: 2 copper layers, 83.5 x 66.0 mm, 125 parts (61 on the bottom side), 66 nets.
