lendres/PCB-Name-Plate-Class-Project/(commit log)

2020-05-02 Initial commit of files.
    [Name Plate Class Project.kicad_pcb, Name Plate Class Project.sch, Page 1.sch, Page 2.sch]
2020-05-16 Switched to Hierarchical
    [Name Plate Class Project.sch, Page 1.sch, Page 3.sch, Page 4.sch, Page 5.sch, Page 6.sch, Page 7.sch, Page 8.sch]
2020-05-17 Updating to Final Revision
    [Name Plate Class Project.sch, Page 1.sch, Page 2.sch, Page 3.sch, Page 4.sch, Page 5.sch, Page 6.sch, Page 7.sch]
2020-05-17 Updating Page Numbering
    [Name Plate Class Project.sch, Page 7.sch, Page 9.sch]
2020-05-17 Updated Page Numbers
    [Page 8.sch]
2020-05-19 Updates to schematic
    Switching to ATMega34UF chip.
    [Name Plate Class Project.sch, Page 1.sch, Page 2.sch, Page 3.sch, Page 4.sch, Page 5.sch, Page 6.sch, Page 7.sch]
2020-05-26 As submitted to class
    [Page 2.sch, Page 6.sch]
2020-05-30 Library Updates
    [Page 2.sch, Page 5.sch]
2020-06-06 Update Page 2.sch
    [Page 2.sch]
2020-06-17 PCB Layout
    [Name Plate Class Project.kicad_pcb, Page 2.sch, Page 3.sch, Page 4.sch, Page 5.sch, Page 6.sch, Page 8.sch]
2020-06-17 PCB Update
    [Name Plate Class Project.kicad_pcb, Page 2.sch, Page 7.sch, Page 8.sch]
2020-06-18 PCB Tweaks
    [Name Plate Class Project.kicad_pcb, Page 8.sch]
2020-06-23 Before removing empty module entries from pcb
    [Name Plate Class Project.kicad_pcb]
2020-07-08 Final Design Files
    Final design files as submitted.
    [Name Plate Class Project.kicad_pcb, Page 1.sch, Page 3.sch]
